SanchakGarg/Hexagon-generator/parts.xlsx

Sheet: Parts
Item | Section | Price (₹) | Qty | Per | Vendor | Description | Total (₹)
LED channels (2 m) | LED channels | ₹50.00 | 1 | 7 LED channels | JSL Lights, Bhagirath Palace | Aluminium channel that holds the LED strip and forms each lit edge. Each 2 m length is cut into seven 27 cm pieces and painted black.
LED strip WS2812B (5 m roll) | LED channels | ₹795.00 | 1 | 20 LED channels | https://quartzcomponents.com/products/led-strip-ws2812b-non-waterproof-60led-mtr | The addressable LEDs that light up the wall, 60 per metre. Each channel takes a 15-LED piece.
Black spray paint | LED channels | ₹200.00 | 1 | hexagon | https://amzn.in/d/0b1TpfeL | Paints the aluminium channels black so only the light shows, not the metal.
2510 4-pin female cable, 30 cm (both ends) | LED channels | ₹2.70 | 1 | LED channel | Gamma Connectronics (+919811582005) | Ready-made cable that plugs a channel into the node at each end, carrying power, data and the spare wire.
Filament (1 kg) | Printed nodes | ₹1349.00 | 1 | 37 nodes | https://robu.in/product/esun-pla-1-75mm-3d-printing-filament-1kg-black/ | Black PLA for 3D-printing the node bodies that hold the boards and join the channels; about 27 g per node.
Touch sensors | Printed nodes | ₹9.50 | 1 | touch sensor | https://robu.in/product/ttp223-touch-key-module-2pcs/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 | TTP223 touch pads fitted in the top of a node so the wall can react when you touch it. Sold in pairs.
Central Node PCBs | Circuit boards |  | 1 | central node | Lion Circuits | The main board at the centre of each hexagon. It carries the ESP32 and drives the six LED chains.
I2C boards (General Node with IO expander) | Circuit boards |  | 1 | io expander node | Lion Circuits | Node board for nodes 3, 6 and 9 that gathers nearby touch sensors and sends them to the centre over I2C. Needs a PCF8574RGTR chip and five 10 kΩ SMD resistors for assembly.
General Node PCBs (without IO expander) | Circuit boards |  | 1 | plain node | Lion Circuits | Node board for every other node. It passes the LED signal on from one channel to the next.
2510 4-pin male connectors | Circuit assembly | ₹1.40 | 6 | node | Gamma Connectronics (+919811582005) | Sockets soldered onto each node board where the LED channel cables plug in (six per board, L1–L6).
3-pin female Dupont wire | Circuit assembly | ₹2.20 | 1 | touch sensor | Gamma Connectronics (+919811582005) | Ready-made lead that connects a touch sensor to its node board.
2-pin SPST slide switch | Circuit assembly | ₹31.00 | 4 | node | https://sharvielectronics.com/product/dth-02-2pin-spst-slide-switch-wanda/ | Small on/off switches on the node boards that set which way the LED signal travels.
Dupont male header, 10-pin | Circuit assembly | ₹8.00 | 1 | 4 hexagon | https://robu.in/product/1x40-berg-strip-male-connector/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 | Pin strip soldered onto the boards for the touch sensor and jumper connections.
XT30 connector pair (male + female) | Circuit assembly | ₹33.00 | 2 | hexagon | https://evelta.com/amass-xt30u-f-xt30u-m-connector-plug-male-female/?sku=515-XT30U-MAGY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 | Plug and socket that bring 5 V power into the General Nodes.
XT60 connector pair (male + female) | Circuit assembly | ₹29.00 | 1 | hexagon | https://robocraze.com/products/xt60-connector-pair?variant=40194049540249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 | Heavier plug and socket that bring 5 V power from the supply into the Central Node.
JST 8-pin connector pair (male + female) | Circuit assembly | ₹20.00 | 1 | central node | Gamma Connectronics (+919811582005) | Plug and socket for the 8-pin JST port on the Central Node board, so its wiring can be unplugged and plugged back in.
24 AWG wire, yellow (m) | Circuit assembly |  | 2.5 | hexagon |  | Thin hook-up wire for the signal wiring, counted in metres. Yellow and green are kept separate so the two signal lines are easy to tell apart.
24 AWG wire, green (m) | Circuit assembly |  | 2.5 | hexagon |  | Thin hook-up wire for the signal wiring, counted in metres; the partner colour to the yellow.
16 AWG wire, red (m) | Circuit assembly |  | 2 | hexagon |  | Thick wire for the 5 V power runs, counted in metres. Red is the + (5 V) side.
16 AWG wire, black (m) | Circuit assembly |  | 2 | hexagon |  | Thick wire for the power runs, counted in metres. Black is the − (ground) side.
ESP32-ETH01 | Power and control | ₹792.00 | 1 | hexagon | https://quartzcomponents.com/products/wt32-eth01-serial-to-ethernet-module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 | The small computer that controls each hexagon's LEDs and talks to the network over Ethernet.
Ethernet cables | Power and control |  | 1 | hexagon |  | Connect each hexagon's ESP32 to the network switch.
5 V 60 A power supply | Power and control | ₹3416.00 | 1 | 2 hexagon | https://sharvielectronics.com/product/lrs-350-5-5v-60a-300w-smps-metal-power-supply-mean-well/ | Mean Well LRS-350-5 that powers the LEDs and boards; one supply runs two hexagons.
Drywall screws | Mounting hardware | ₹0.47 | 2 | node | https://onlyscrews.in/products/3-5mm-x-13mm-phillips-bugle-head-gypsum-drywall-screw | Fix each node to the backboard or wall.
M3 screws | Mounting hardware | ₹1.42 | 3 | node | https://omrook.com/ss-allen-bolt-m3-x-6mm-dia-3mm-length-6mm-stainless-steel-ss202-socket-head-cap-screws/ | Hold the circuit board and the printed plates of each node together.
M3 nuts | Mounting hardware | ₹0.59 | 3 | node | https://omrook.com/m3-3mm-hex-nut-black/ | Lock the M3 screws in place.
M3 × 6 mm standoffs (nylon) | Mounting hardware | ₹4.40 | 3 | node | https://onlyscrews.in/products/m3-x-6mm-male-to-female-nylon-hex-threaded-standoff-spacer | Spacers that hold the circuit board just above the plate so nothing shorts.
Backboard sheets | Mounting hardware |  | 1 | backboard |  | Plywood or MDF sheets the backboard is cut from. How many you need, and the DXF to cut them, come from the Backboard sheets page.

Sheet: Settings
Name | Value | Note
Channel_cm | 27 | each LED channel is cut this long, in cm
Length_cm | 200 | aluminium channel is bought in lengths of this many cm
Channels_per_length | ROUNDDOWN(Length_cm/Channel_cm,0) | worked out: channels cut from each length
LEDs_per_channel | 15 | LEDs in each channel
LEDs_per_m | 60 | LEDs per metre of WS2812B strip
Node_grams | 27 | grams of filament per printed node

Sheet: Read me
Hexagon Wall Planner · parts list
The app reads this file once, when the server starts. After editing it, run ./hexwall.sh restart.
If something is wrong, the app shows which cell, and the server log lists it too.
Parts sheet: one row per item
Item: its name. Section: the heading it goes under; sections appear in the order they first come up (LED channels, Printed nodes, Circuit boards, Circuit assembly, Power and control, Mounting hardware).
Price (₹): price for one, in rupees. Blank shows -- and leaves it out of the totals. Or leave Price blank and put the Total (₹): what the Qty in that row costs altogether, e.g. Qty 2.5 per hexagon and Total 50 means ₹50 per hexagon; the price of one is worked out from it.
Qty and Per: how many, counted per something on the wall. The total is rounded up.
3 per node · 1 per hexagon · 2 per LED channel · 1 per 7 LED channels (one 2 m length gives 7 channels)
Per can be: wall, hexagon, node, central node, other node (every node but the central ones), io expander node (a General Node whose touch sensor group runs to the centre over I2C), plain node (a General Node without the IO expander), touch sensor, LED channel, backboard.
Leave Per blank for a fixed number for the whole wall. Leave Qty blank if not known yet.
backboard counts the backboard sheets the Backboard sheets page lays out, 0 when the backboard is off; an item that comes to 0 is left off the list.
Vendor: shop link, phone or name. Description: anything else. Both show on the build guide (page 4), where they can be changed for one guide.
Settings sheet
Numbers the build guide uses in its steps and channel drawing. Keep every row; a value may be a formula on the rows above, e.g. ROUNDDOWN(Length_cm/Channel_cm,0).
