SanchakGarg/Hexagon-generator/Circuits/CentralNode/gerber/BOM-PCBPower.xlsx

Refrence Designator | Quantity | Value | link | Manufacturer part number | PCB footprint | Description | Remarks | item number
R1,R2,R3 | 3 | 10K | https://robu.in/product/rc0805jr-0710kl-yageo-smd-chip-resistor-10-kohm-%C2%B1-5-125-mw-0805-2012-metric-thick-film-precision-pack-of-10/ | RC0805JR-0710KL | Resistor_SMD:R_0805_2012Metric | 10 kΩ 0805 SMD resistor |  | 7
U1 | 1 | PCF8574RGTR | https://robu.in/product/pcf8574rgtr-texas-instruments-wqfn-16-ep3x3-i-o-expanders-rohs/ | PCF8574RGTR | PCF8574RGTR:QFN50P300X300X100-17N | 8-bit 2.5–5.5 V I²C/SMBus I/O expander with interrupt |  | 11
