SanchakGarg/Hexagon-generator/Circuits/GeneralNode/General Node/.step

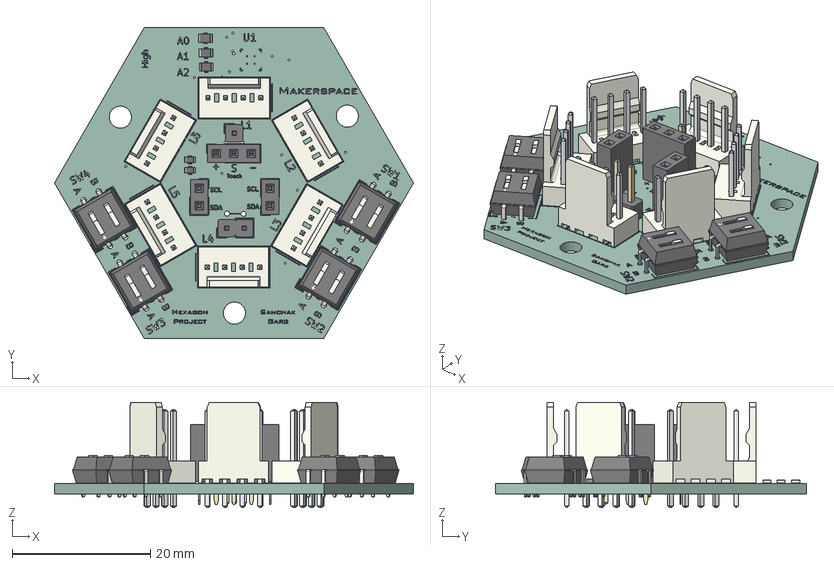
[picture p1: CAD file, 2026-10-25]
Circuits/GeneralNode/General Node/.step
52.0 x 45.0 x 15.3 mm
Molex_KK-254_AE-6410-04A_1x04_P2.54mm_Vertical x 6
PinSocket_1x02_P2.54mm_Vertical x 2
SW_DIP_SPSTx02_Slide_6.7x6.64mm_W7.62mm_P2.54mm_LowProfile x 4
R_0805_2012Metric x 3
PinHeader_1x01_P2.54mm_Vertical
PinHeader_1x02_P2.54mm_Vertical
PinSocket_1x03_P2.54mm_Vertical
R_0603_1608Metric x 2
GeneralNode_silkscreen
GeneralNode_PCB
