SanchakGarg/Hexagon-generator/Edge/assets/top_plate.stl

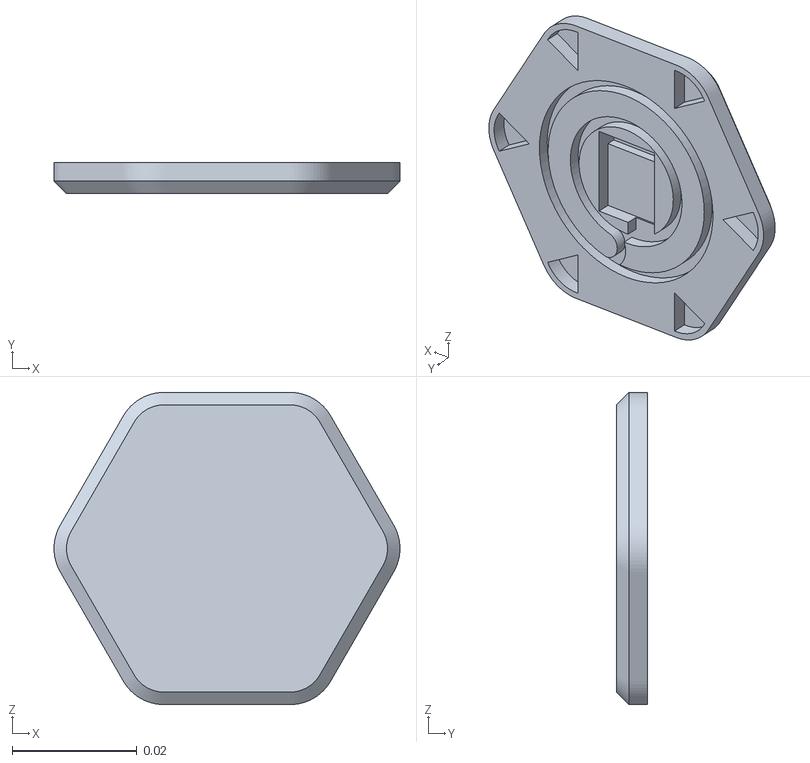
[picture p2: CAD file, 2026-10-19]
Edge/assets/top_plate.stl
0.0554 x 0.005 x 0.05
