SanchakGarg/Hexagon-generator/Edge/assets/bottom_plate.stl

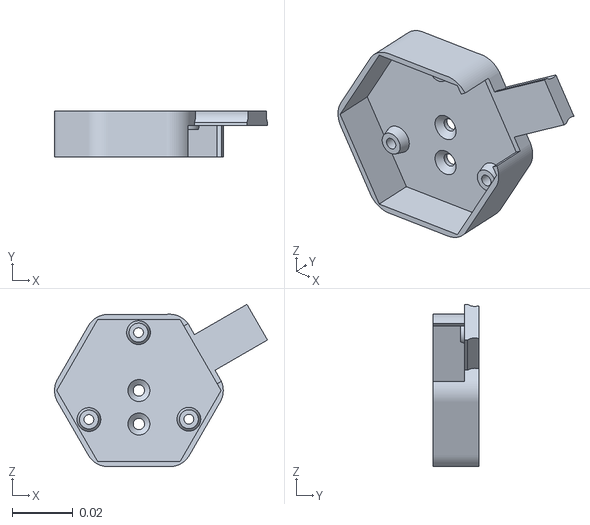
[picture p3: CAD file, 2026-10-19]
Edge/assets/bottom_plate.stl
0.0699 x 0.015 x 0.0533
