SanchakGarg/Hexagon-generator/Edge/assets/bottom_plate_cover.stl

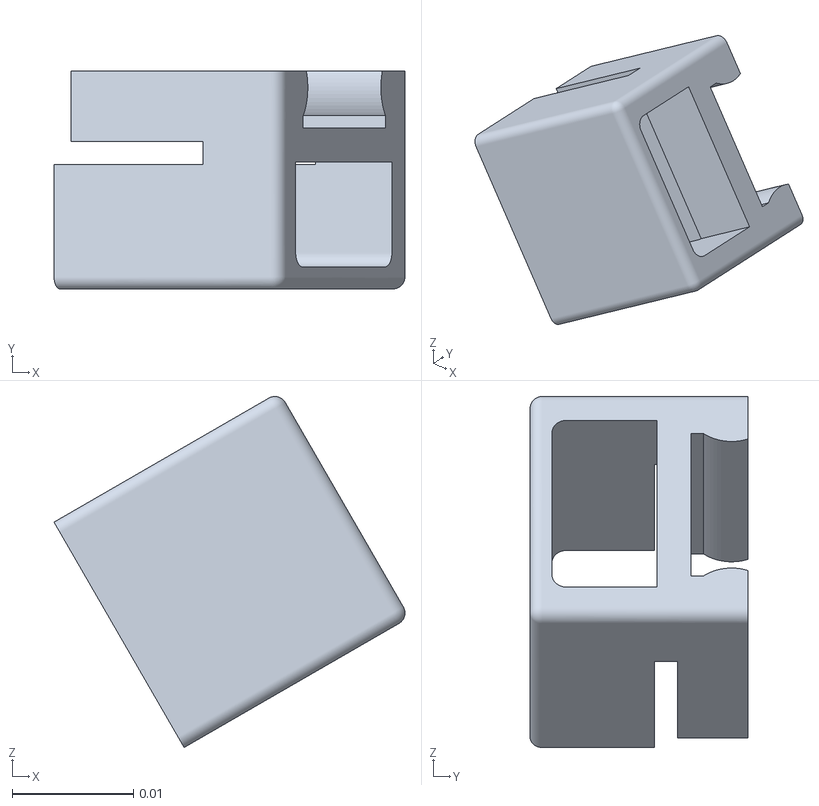
[picture p4: CAD file, 2026-10-19]
Edge/assets/bottom_plate_cover.stl
0.029 x 0.018 x 0.029
