SanchakGarg/Hexagon-generator/Edge/assets/led_channel.stl

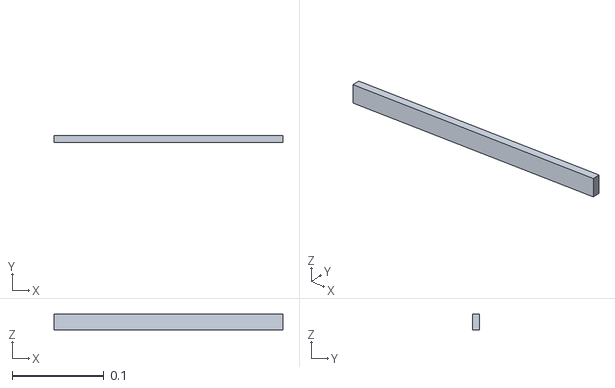
[picture p5: CAD file, 2026-10-19]
Edge/assets/led_channel.stl
0.25 x 0.0075 x 0.0174
