SanchakGarg/Hexagon-generator/Edge/assets/middle_plate.stl

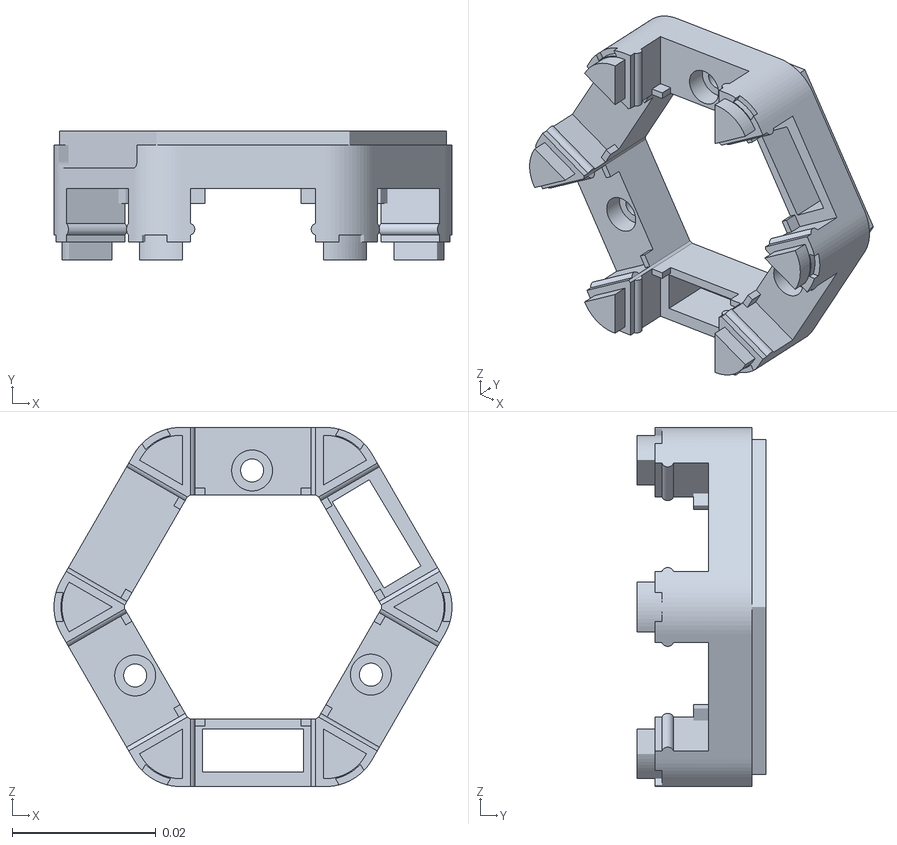
[picture p6: CAD file, 2026-10-19]
Edge/assets/middle_plate.stl
0.0554 x 0.018 x 0.05
