SanchakGarg/Hexagon-generator/Circuits/GeneralNode/GeneralNode.kicad_pcb

## KiCad design Circuits/GeneralNode/GeneralNode.kicad_pcb (2026-11-04)

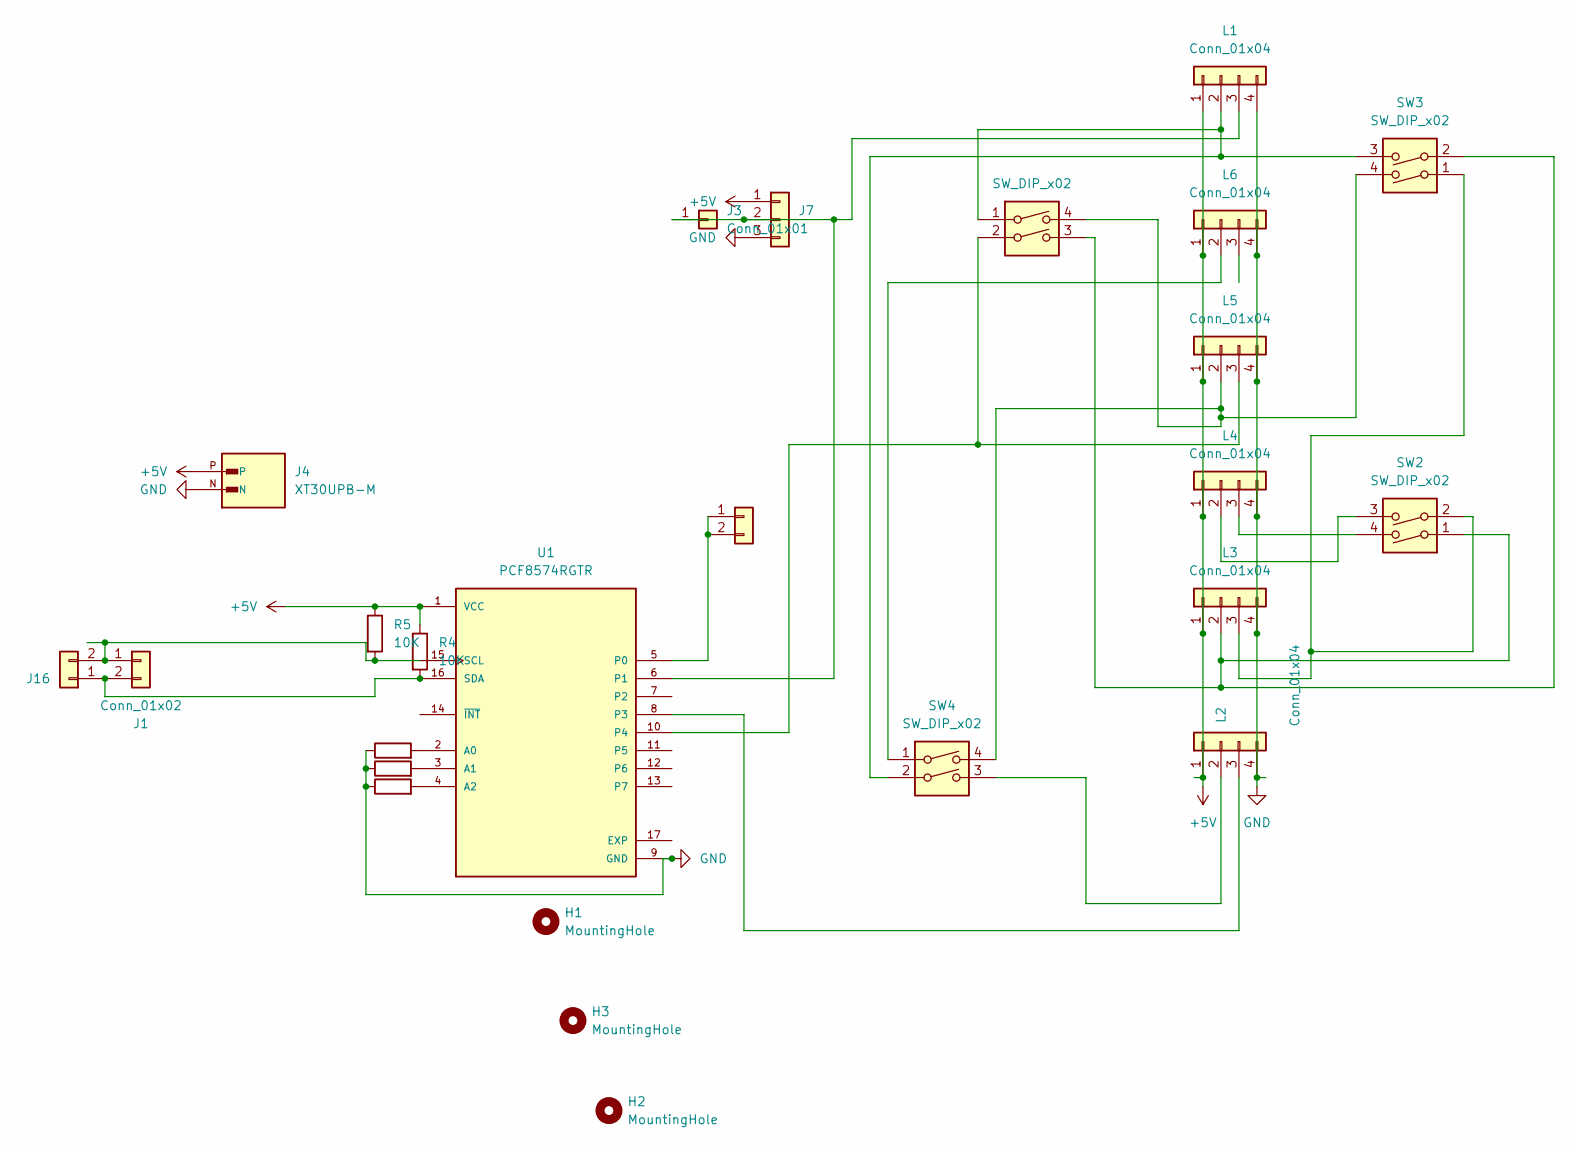
[picture p7: schematic GeneralNode.kicad_sch]

Parts:
H1, H2, H3: MountingHole; MountingHole_3.2mm_M3
J1, J16: Conn_01x02; PinSocket_1x02_P2.54mm_Vertical
J2: Conn_01x02; PinHeader_1x02_P2.54mm_Vertical
J3: Conn_01x01; PinHeader_1x01_P2.54mm_Vertical
J4: XT30UPB-M; AMASS_XT30UPB-M
J7: Conn_01x03; PinSocket_1x03_P2.54mm_Vertical
L1, L2, L3, L4, L5, L6: Conn_01x04; Molex_KK-254_AE-6410-04A_1x04_P2.54mm_Vertical
R1, R2, R3: 10K; R_0805_2012Metric
R4, R5: 10K; R_0603_1608Metric
SW1, SW2, SW3, SW4: SW_DIP_x02; SW_DIP_SPSTx02_Slide_6.7x6.64mm_W7.62mm_P2.54mm_LowProfile
U1: PCF8574RGTR; QFN50P300X300X100-17N; PARTREV J

Connections:
+5V: J4.P, J7.1, L1.1, L2.1, L3.1, L4.1, L5.1, L6.1, R4.1, R5.1, U1.1 (VCC)
GND: J4.N, J7.3, L1.4, L2.4, L3.4, L4.4, L5.4, L6.4, R1.1, R2.1, R3.1, U1.9 (GND)
unnamed: J1.1, J16.2, R5.2, U1.15 (SCL)
unnamed: J1.2, J16.1, R4.2, U1.16 (SDA)
unnamed: J2.1, J2.2, U1.5 (P0)
unnamed: J3.1 (Pin_1_1), J7.2, L1.3, U1.6 (P1)
unnamed: L1.2, SW1.1, SW3.3, SW4.2
unnamed: L2.2, SW4.3
unnamed: L2.3, U1.8 (P3)
unnamed: L3.2, SW1.3, SW2.1, SW3.2
unnamed: L3.3, SW2.2, SW3.1
unnamed: L4.2, SW2.3
unnamed: L4.3, SW2.4
unnamed: L5.2, SW1.4, SW3.4, SW4.4
unnamed: L5.3, SW1.2, U1.10 (P4)
unnamed: L6.2, SW4.1
unnamed: R1.2, U1.2 (A0)
unnamed: R2.2, U1.3 (A1)
unnamed: R3.2, U1.4 (A2)

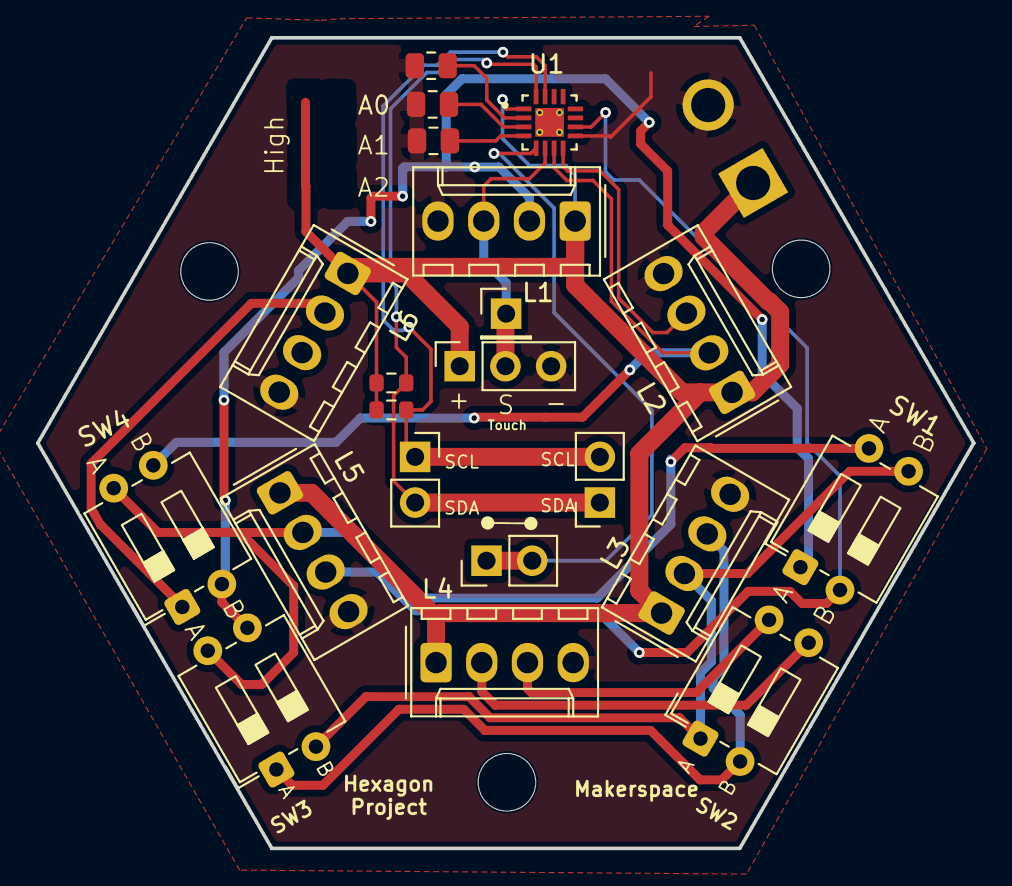
[picture p8: board GeneralNode.kicad_pcb from above]

Board: 2 copper layers, 52.0 x 45.0 mm, 25 parts (1 on the bottom side), 19 nets.
