SanchakGarg/Hexagon-generator/Circuits/CentralNode/CentralNode.kicad_pcb

## KiCad design Circuits/CentralNode/CentralNode.kicad_pcb (2026-10-25)

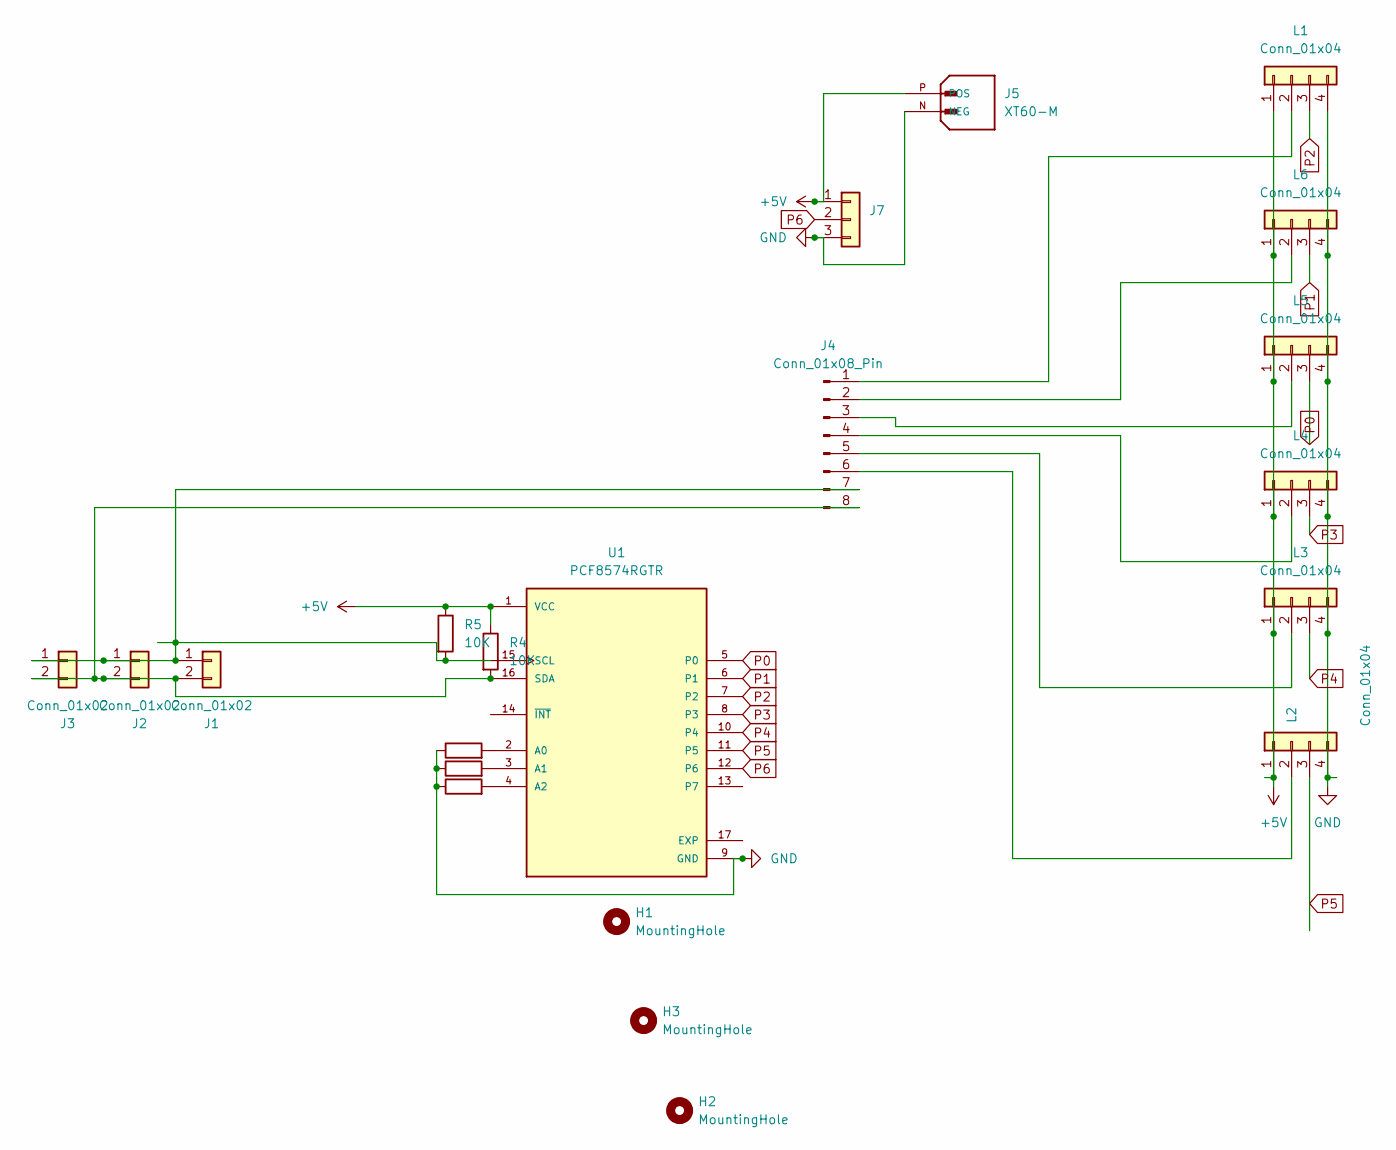
[picture p9: schematic CentralNode.kicad_sch]

Parts:
H1, H2, H3: MountingHole; MountingHole_3.2mm_M3
J1, J2, J3: Conn_01x02; PinSocket_1x02_P2.54mm_Vertical
J4: Conn_01x08_Pin; JST_EH_B8B-EH-A_1x08_P2.50mm_Vertical
J5: XT60-M; AMASS_XT60-M; PARTREV V1.2
J7: Conn_01x03; PinSocket_1x03_P2.54mm_Vertical
L1, L2, L3, L4, L5, L6: Conn_01x04; Molex_KK-254_AE-6410-04A_1x04_P2.54mm_Vertical
R1, R2, R3: 10K; R_0805_2012Metric
R4, R5: 10K; R_0603_1608Metric
U1: PCF8574RGTR; QFN50P300X300X100-17N; PARTREV J

Connections:
+5V: J5.P (POS), J7.1, L1.1, L2.1, L3.1, L4.1, L5.1, L6.1, R4.1, R5.1, U1.1 (VCC)
GND: J5.N (NEG), J7.3, L1.4, L2.4, L3.4, L4.4, L5.4, L6.4, R1.1, R2.1, R3.1, U1.9 (GND)
unnamed: J1.1, J2.1, J3.1, J4.7, R5.2, U1.15 (SCL)
unnamed: J1.2, J2.2, J3.2, J4.8, R4.2, U1.16 (SDA)
unnamed: J4.1, L1.2
unnamed: J4.2, L6.2
unnamed: J4.3, L5.2
unnamed: J4.4, L4.2
unnamed: J4.5, L3.2
unnamed: J4.6, L2.2
unnamed: R1.2, U1.2 (A0)
unnamed: R2.2, U1.3 (A1)
unnamed: R3.2, U1.4 (A2)
P0: L5.3, U1.5 (P0)
P1: L6.3, U1.6 (P1)
P2: L1.3, U1.7 (P2)
P3: L4.3, U1.8 (P3)
P4: L3.3, U1.10 (P4)
P5: L2.3, U1.11 (P5)
P6: J7.2, U1.12 (P6)

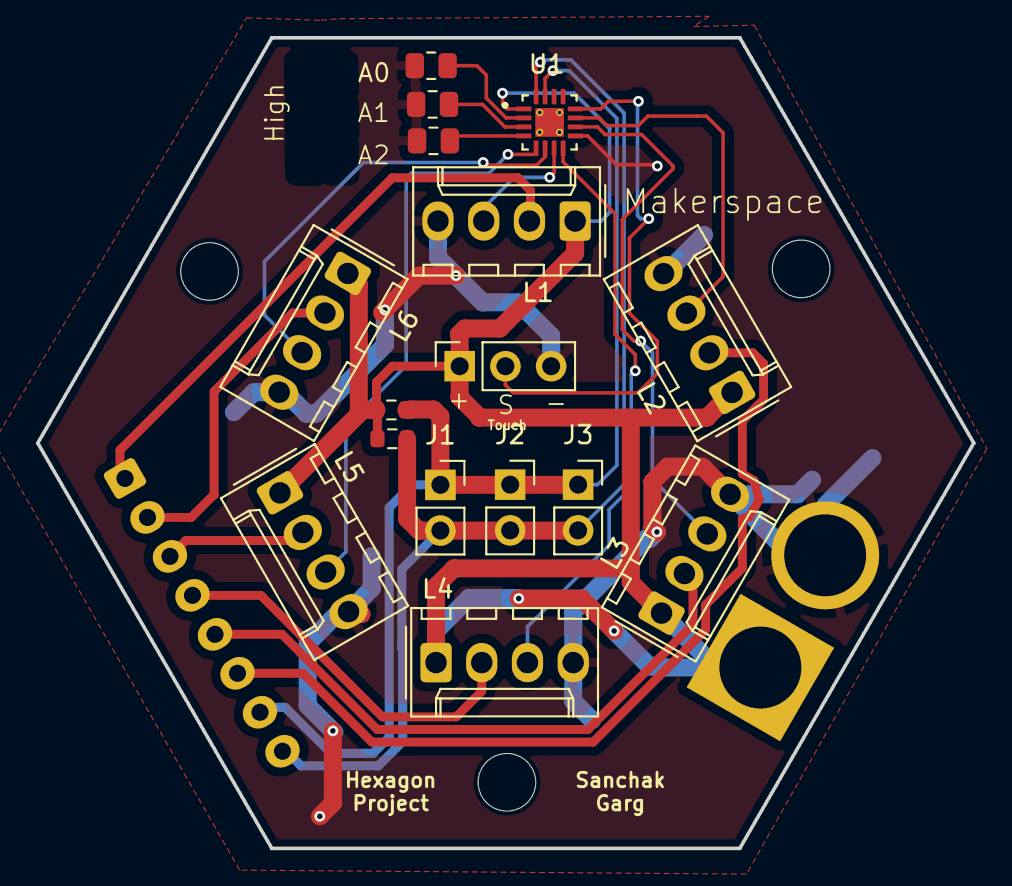
[picture p10: board CentralNode.kicad_pcb from above]

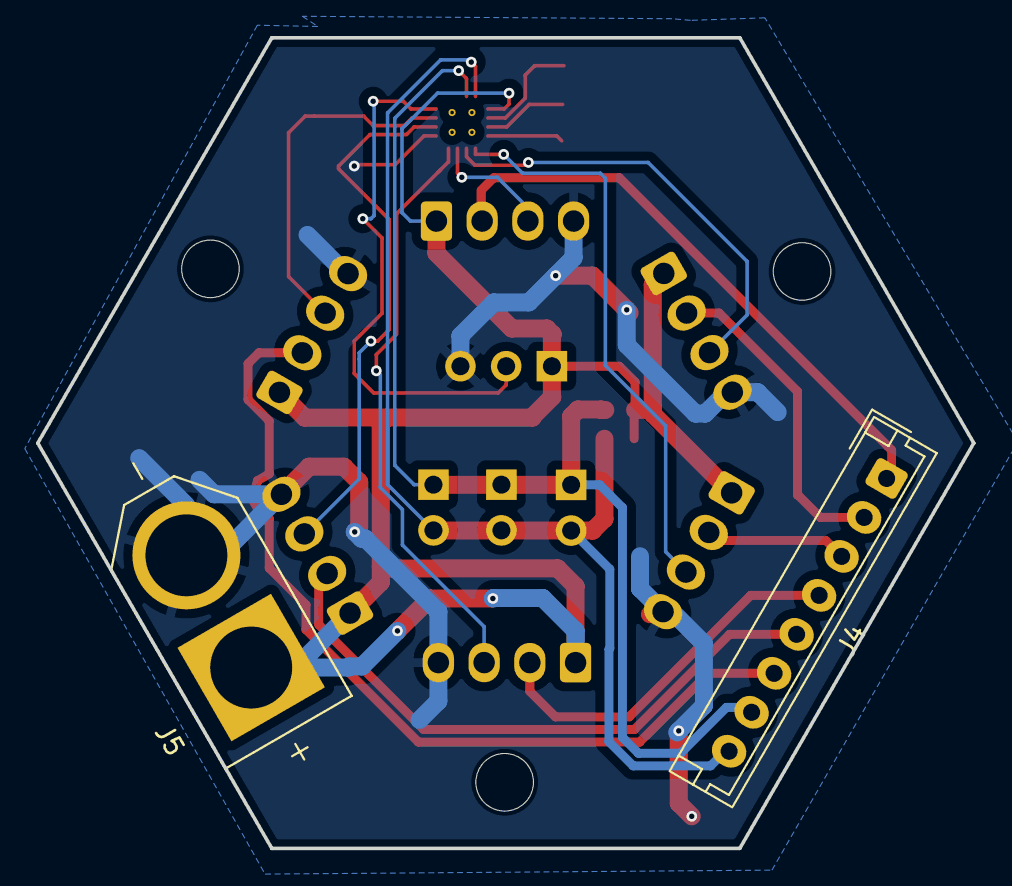
[picture p11: board CentralNode.kicad_pcb from below]

Board: 2 copper layers, 52.0 x 45.0 mm, 21 parts (2 on the bottom side), 20 nets.
