SanchakGarg/Hexagon-generator/(commit log)

2026-10-19 chore: add Onshape-exported Hexagon and Node robot models
    [bottom_plate.stl, bottom_plate_cover.stl, fusioncomponent.stl, fusioncomponent__2.stl, led_channel.stl, middle_plate.stl, part_1.stl, robot.urdf]
2026-10-19 feat: derive honeycomb lattice and node mating from URDF frames
2026-10-19 feat: add 3D view built from the URDF STL meshes
2026-10-19 feat: add Edge part URDF and meshes
    [bottom_plate.stl, bottom_plate_cover.stl, led_channel.stl, middle_plate.stl, robot.urdf, top_plate.stl]
2026-10-19 feat: attach Edge pieces to open sides at border nodes
    Edge's edge-1 frame mates the free node frame (node-1 first, then node-3 or node-5) that points along a honeycomb side no hexagon builds. Edges that would leave the wall are skipped.
2026-10-19 feat: render the 2D view from the STL meshes with a fixed front camera
    2D and 3D now share one three.js scene. 2D uses an orthographic camera matched to the SVG overlay, which keeps the dimensions, labels and hover tooltips. It supports zoom and pan but no rotation.
2026-10-19 feat: attach an Edge to every edge node on node-1 or node-5
    Edge nodes on a hexagon's left corners are turned 120° so node-1 or node-5 faces the open side. Edges may now overhang the wall, and the 2D frame and 3D camera include them.
2026-10-19 feat: ripple a hovered hexagon's own parts out from its centre
    Only the hovered hexagon moves. Its parts come out ring by ring: the centre plate stack, then the channels around it, then the next stacks, and so on. They stay out while hovered and go back in the same centre-first order. Replaces the wall-wide ripple.
2026-10-19 feat: connect Edges on node-1 or node-3 instead of node-5
    Edge nodes on a hexagon's 150°, 210°, 270° and 330° corners now keep the standard node turn, so the hexagon joint follows the original rule. Only the 30° and 90° corners are turned.
2026-10-19 fix: hover hexagons anywhere inside their outline
    Pick the hexagon by testing the pointer against its outline on the wall plane, so channels and the gaps between them count, not only the plate stacks. Raise the parts higher and keep a wave rippling through them while hovered. They settle back down only when the pointer leaves.
2026-10-19 feat: swap Edge frames, one Edge per hexagon side, Edges join their hexagon
    Edges that mated node-3 now mate node-1 and the reverse. Where both ends of a
    hexagon side are edge nodes only one takes an Edge. Each Edge belongs to its
    hexagon: it hovers, selects and lifts with it. Hovering a hexagon shows its
    own stats in a card.
2026-10-19 feat: pin Edge frames per corner and lift corner nodes with their hexagon
    Edges mate node-3 on top, node-2 at the bottom and node-5 on the left and
    right, with the node turned to face that frame out. Only vertical sides limit
    to one Edge, on the upper corner. A hovered hexagon's corner nodes now lift
    with it; a shared node goes with the hexagon that claimed it last.
2026-10-19 fix: lay Edges along the hexagon sides a missing neighbour would build
    A hexagon panel builds its right, upper-left and lower-left sides; the
    neighbour across each other side builds that one. Where the neighbour is
    missing an Edge now completes that side, mating edge-1 to the node at its
    upper-pointing end on the frame that runs along the side. Nodes keep their
    standard turn, so the hexagon joints follow the original rule again.
2026-10-19 fix: centre the assembly vertically on the rows that hold hexagons
    A wall too narrow for the shifted rows left them empty, and centring still counted them, so the hexagons sat up to 450 mm high. Centring now spans only the filled rows.
2026-10-19 fix: re-centre the assembly after excluding hexagons
    Excluded hexagons left the rest where the full fill had put them. The grid now slides so the kept hexagons sit centred on the wall, excluded outlines move with it and stay in frame, and an unzoomed 2D view refits.
2026-10-20 feat: give each node one owning hexagon and mate Edges at both ends
    Every node now belongs to a single hexagon, even a 2-way or 3-way one: the first of the 30°, 330°, 150°, 210°, 270°, 90° corners it fills, so a full wall gives each hexagon the two nodes of its right side. Hover lifts only the nodes a hexagon owns, hovering a node picks its owner, and the hover card counts owned nodes.
    Edges now mate the node at each end on node-1, node-3 or node-5, with edge-1 on the node-1 end when the side has one; joints count both ends.
2026-10-20 feat: mate 11/21/31 to node-5 and 12/22/32 to node-1, Edges on node-1
    Restarts from before the node-ownership change. Each node is now turned for the hexagon frame it mates, so on a lone hexagon the upward corners (11, 21, 31) take node-5 and the downward ones (12, 22, 32) take node-1. That turn points node-1 of each upward node along the open side, where edge-1 mates. On a shared node the hexagon with an Edge there sets the turn, else 11 or 22 first; the others mate whichever frame faces them. The default wall is 1.3 m by 1.3 m, one hexagon.
2026-10-20 feat: give each node one owning hexagon
    A 2-way or 3-way node now belongs to the hexagon that sets its turn, the one that mates its preferred frame there. Hover lifts only the nodes a hexagon owns, hovering a node picks its owner, and the hover card and node tooltip show ownership.
2026-10-20 fix: cut the backboard to the hexagon outline and run its side walls back from it
2026-10-20 feat: pastel notebook UI with Patrick Hand, light/dark themes remembered per browser
    Taped index-card panel with collapsible sections, sticker buttons, checklist
    layer toggles, spiral-bound drawing page, and sketchy double-pencil outlines
    in the 2D drawing. Light is the default; switching saves the choice in
    localStorage.
2026-10-20 feat: cel-shaded 3D with ink outlines, part colours follow the theme
    Toon materials on a three-band ramp, an inverted-hull outline of fixed pixel
    width that rides the instance matrices, and every part colour read from the
    page's CSS variables so switching theme recolours the meshes.
2026-10-20 feat: springy hover, pop-in/pop-out hexagons and a camera fly between 2D and 3D
    Hover parts ride an underdamped spring; new grid positions pop onto the wall
    from the centre outward and excluded ones swell and spin away; a picked
    hexagon gives a quick boing; switching view flies the camera between the
    front view and the orbit view, with the 2D overlay returning on landing.
    All of it is skipped under prefers-reduced-motion.
2026-10-21 feat: node and LED totals from the models, grouped show list, backboard card with on/off, view switch on the drawing
2026-10-21 feat: two-page configurator with a parts list, named saves in the browser, and nodes that can skip their touch sensor
2026-10-21 feat: save from the tab's own mark or ⌘S/Ctrl+S, autosave saved tabs every 5 minutes, drop the Save button; totals read Nodes and LED channels
2026-10-21 feat: saves pop a toast; parts list counts nodes, LED channels and 2 m channel lengths for the hexagons shown; favicon
2026-10-21 feat: parts list in priced sections (LED channels, nodes, network and control, miscellaneous) with rupee subtotals and a grand total
2026-10-21 feat: touch sensors priced at ₹19 a pair
2026-10-21 feat: touch sensors priced singly at ₹9.50
2026-10-21 feat: wiring diagram on the node labels page: six chains per hexagon in their own colours, SIG and FREE runs with switch rings, 5V/GND, IN/OUT connectors, curved wires in 2D and tubes in 3D, and a ke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
2026-10-21 fix: wiring key hover picks out a chain without flicker; other wires fade instead of vanishing; key drops the wire paths
2026-10-21 feat: chains renamed L1–L6; hovering a wire picks out that chain in just that hexagon; wider hover strips along every channel
2026-10-21 feat: labels page switches between strip wiring and LED channels, with an arrow from DIN to DOUT on every channel in 2D and 3D
2026-10-21 feat: LED channel arrows are small and centred on each channel; hovering still works along the whole channel
2026-10-21 feat: touch sensor wiring view; LED channels view first and default with double-size arrows; joining nodes turn so node-1 faces the outer node their sensor is wired to
2026-10-21 feat: touch sensor groups named M, T1, T2, T3
2026-10-21 feat: hovering a hexagon on the labels page picks out all its wiring; strip wiring key gets a connector diagram and pin details
2026-10-22 feat: parts list is page 2 and connections and wiring page 3; paler LED channels behind the wiring; a pulse runs down a hovered chain; T1-T3 go on to M as twisted pairs; second M3 screws line at ₹0.9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
2026-10-22 docs: the touch sensor twisted pairs are named as SDA / SCL in the key and tooltips
2026-10-22 feat: hovering a chain in the LED channels view shows its FREE-wire bypass dotted with rings at the switches, and the pulse runs hop by hop through it
2026-10-22 feat: the ₹0.95 line is M3 nuts; the parts list downloads as an editable Excel sheet with counts, quantity formulas and totals
2026-10-22 feat: page 4 is a sketchbook build guide (wall sketch, build steps, node layers in 3D, the LED channel up close, node and channel placements a hexagon at a time, an editable parts list with Excel and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
2026-10-22 feat: the build guide's drawings are stills of the URDF meshes, as on page 3, with nodes and arrows drawn by hand on top; a single hexagon is cut out on its own frame, nodes and Edges, with nothing o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
2026-10-25 feat: Central and General Node Circuits
    [.step, BOM-PCBPower.xlsx, CentralNode.kicad_pcb, CentralNode.kicad_sch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]
2026-10-25 feat: the parts list, its prices and the build constants come from parts.xlsx, which the server reads and checks once as it starts; a mistake in the sheet is named by cell in the log and on the page;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
    [parts.xlsx]
2026-10-25 feat: parts.xlsx is one row per item (Item, Section, Price, Qty, Per, Vendor, Description); Qty is counted per hexagon, node, LED channel and so on, or per a number of them, and rounded up; vendor an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
    [parts.xlsx]
2026-10-26 feat: the configurator is Configure, Touch sensors (pick nodes over the live sensor wiring) and Parts list, and Finish opens the assembly guide: a paged book with its contents in the side panel and a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
2026-10-26 update: parts list
    [parts.xlsx]
2026-10-26 feat: an Edit design button in the assembly guide's footer takes you back to the configurator, standing where Next was on the last page; a vendor that is a link shows as the shop's name, linked, in t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
2026-11-04 feat: the parts list is regrouped in build order (LED channels, printed nodes, circuit boards, circuit assembly, power and control, mounting hardware) with a description on every item; General Node b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
    [parts.xlsx]
2026-11-04 feat: a Backboard sheets page (page 3) takes the size of one sheet (4 × 5 ft by default, or 4 × 8 ft), lays the fewest sheets over the board, numbers them on the drawing and exports every sheet's cut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
    [parts.xlsx]
2026-11-04 update: General Node board and schematic
    [GeneralNode.kicad_pcb, GeneralNode.kicad_sch]
2026-11-04 update: parts list descriptions made brief; I2C boards note the PCF8574RGTR and five 10 kΩ resistors needed for assembly
    [parts.xlsx]
2026-11-04 update: parts list descriptions say plainly what each item is and what it is for
    [parts.xlsx]
2026-11-04 update: parts list adds the JST 8-pin connector pair for the Central Node, 24 AWG yellow and green wire and 16 AWG red and black wire
    [parts.xlsx]
2026-11-04 feat: an item can be priced by its final cost instead of the price of one: a Total column in parts.xlsx, and a typeable Amount in the guide's Edit mode, with the price each worked out from it
    [parts.xlsx]
2026-11-04 update: no yellow marking on edited parts; the parts PDF has a bold title, no 'prices in rupees' line and no browser header; JST connector from Gamma Connectronics
    [parts.xlsx]
2026-11-11 feat: View in AR on iPhone and iPad puts the build on a real wall at actual size through AR Quick Look, where LiDAR finds the wall, it slides along it, and the shutter button saves photos to Photos
2026-11-11 feat: a Realistic AR switch shows the build as it will look: a white backboard, black plates, nodes and LED channels, and each channel's warm light glowing on the board behind it
